reportingsjr/mppt/readme.md

Embedded Systems 4038C Final Project
Solar Panel Maximum Power Point Tracker
