reportingsjr/mppt/datasheets/IV_curve_solar_cell.png

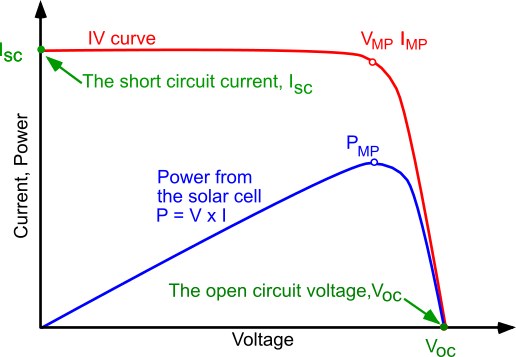
datasheets/IV_curve_solar_cell.png
