reportingsjr/mppt/hardware/mppt_power_controller.png

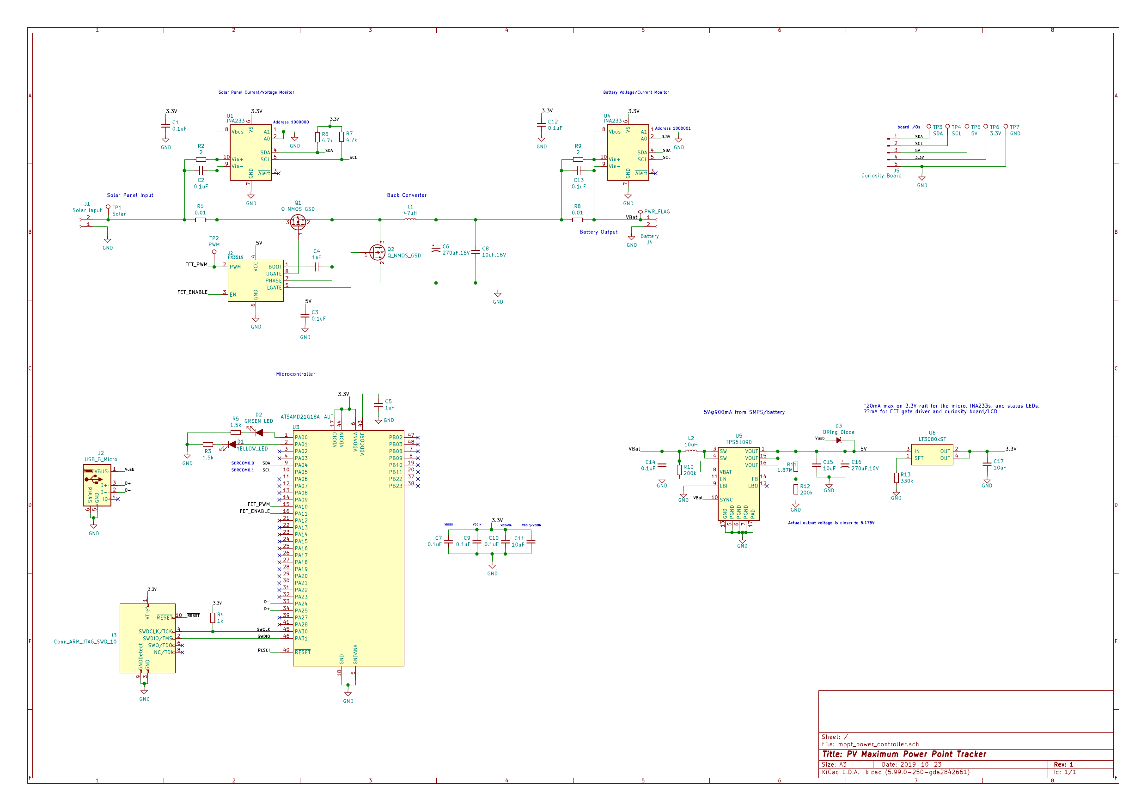
hardware/mppt_power_controller.png
