reportingsjr/mppt/hardware/mppt_power_controller.pdf

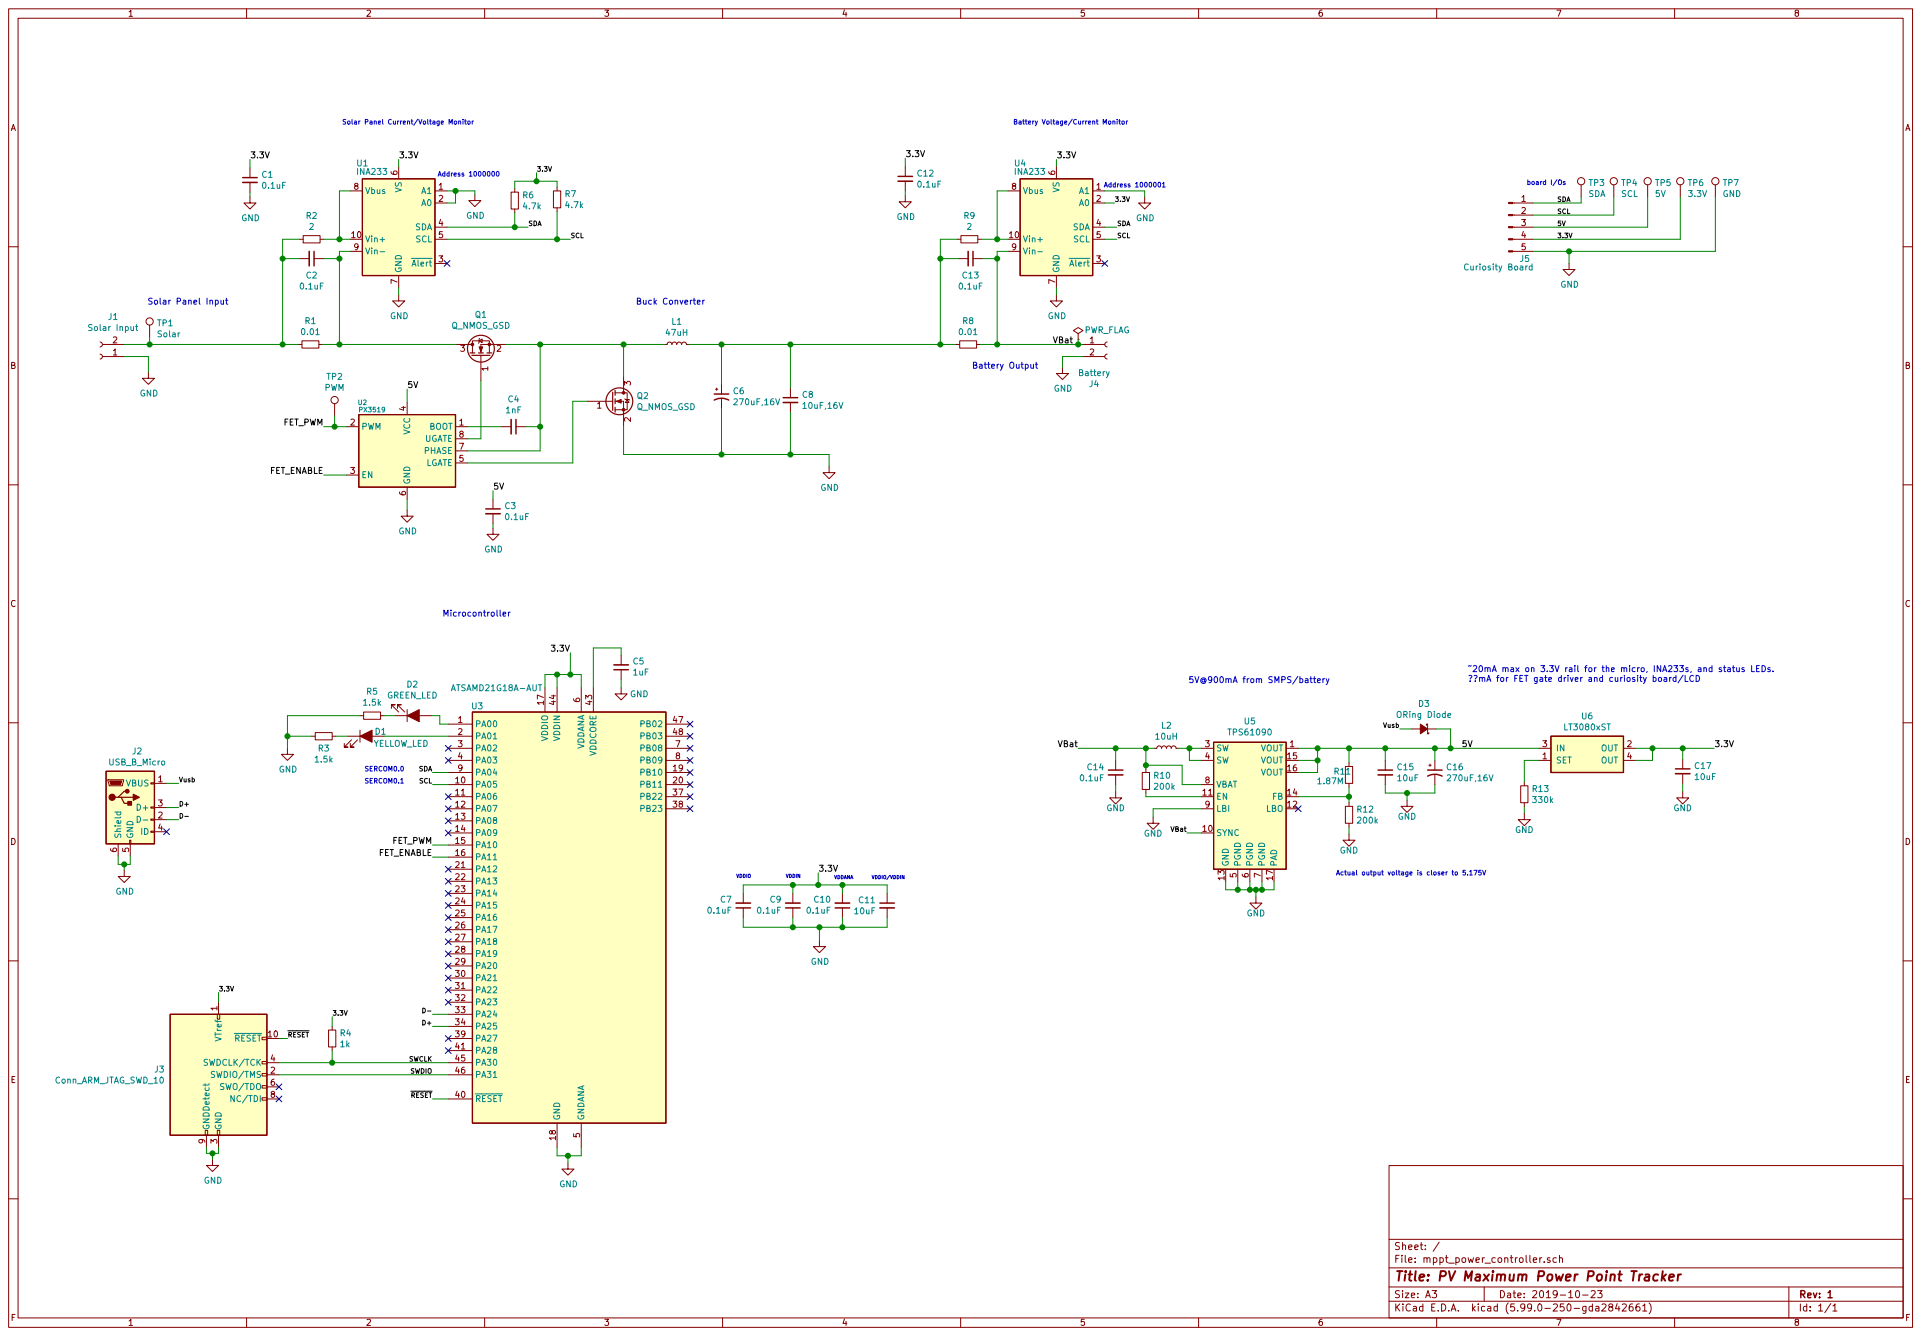
[picture p3: page 1]

5V@900mA from SMPS/battery Microcontroller 1

2 3 Q2 Q_NMOS_GSD VTref 1 RESET 10 SWDIO/TMS 2 GND

20mA max on 3.3V rail for the micro, INA233s, and status LEDs. ??mA for FET gate driver and curiosity board/LCD

3 SWDCLK/TCK 4 SWO/TDO 6 NC/TDI 8 GNDDetect 9

File: mppt_power_controller.sch Sheet: /
Id: 1/1 Title: PV Maximum Power Point Tracker
