reportingsjr/mppt/hardware/mppt_power_controller.kicad_pcb

## KiCad design hardware/mppt_power_controller.kicad_pcb (2020-04-10)

Schematic: mppt_power_controller.sch, PV Maximum Power Point Tracker

Parts:
C1, C2, C7, C9, C10, C12, C13, C19: 0.1uF; C_0603_1608Metric_Pad1.05x0.95mm_HandSolder
C3, C8: 10uF,16V; C_0805_2012Metric_Pad1.15x1.40mm_HandSolder
C4: 0.47uF; C_0603_1608Metric_Pad1.05x0.95mm_HandSolder
C5: 1uF; C_0603_1608Metric_Pad1.05x0.95mm_HandSolder
C11, C14, C15, C17: 10uF; C_0805_2012Metric_Pad1.15x1.40mm_HandSolder
C18: 270uF,16V; CP_Elec_8x6.9
D1: YELLOW_LED; LED_0603_1608Metric_Pad1.05x0.95mm_HandSolder
D2: GREEN_LED; LED_0603_1608Metric_Pad1.05x0.95mm_HandSolder
D3, D5: ORing Diode; D_SMB_Handsoldering
D4: D_SMB_Handsoldering
H1, H2, H3, H4: MountingHole; MountingHole_3.2mm_M3
J1: Solar Input; JST_PH_S2B-PH-K_1x02_P2.00mm_Horizontal
J2: USB_B_Micro; USB_Micro-B_Amphenol_10103594-0001LF_Horizontal
J3: Conn_ARM_JTAG_SWD_10; PinHeader_2x05_P1.27mm_Vertical_SMD
J4: Battery; JST_PH_S2B-PH-K_1x02_P2.00mm_Horizontal
J5: DISPLAY; JST_PH_S4B-PH-K_1x04_P2.00mm_Horizontal
L1: 10uH; L_Taiyo-Yuden_NR-80xx_HandSoldering
R1, R8: 0.01; R_0603_1608Metric_Pad1.05x0.95mm_HandSolder
R2, R9: 2; R_0603_1608Metric_Pad1.05x0.95mm_HandSolder
R3, R5: 1.5k; R_0603_1608Metric_Pad1.05x0.95mm_HandSolder
R4: 1k; R_0603_1608Metric_Pad1.05x0.95mm_HandSolder
R6, R7: 4.7k; R_0603_1608Metric_Pad1.05x0.95mm_HandSolder
R10, R11: 120k; R_0603_1608Metric_Pad1.05x0.95mm_HandSolder
R13: 330k; R_0603_1608Metric_Pad1.05x0.95mm_HandSolder
TP1: Solar; TestPoint_Keystone_5019_Minature
TP2, TP7: GND; TestPoint_Keystone_5019_Minature
TP3: SDA; TestPoint_Keystone_5019_Minature
TP4: SCL; TestPoint_Keystone_5019_Minature
TP5: Buck_EN; TestPoint_Keystone_5019_Minature
TP6: 3.3V; TestPoint_Keystone_5019_Minature
TP8: Battery; TestPoint_Keystone_5019_Minature
U1, U4: INA233; VSSOP-10_3x3mm_P0.5mm
U2: LT3971; MSOP-10-1EP_3x3mm_P0.5mm_EP1.68x1.88mm
U3: ATSAMD21G18A-AUT; TQFP-48_7x7mm_P0.5mm
U5: AD5141; QFN-16-1EP_3x3mm_P0.5mm_EP1.45x1.45mm
U6: LT3080xST; SOT-223

Connections:
/3.3V: C1.1, C7.2, C9.2, C10.2, C11.1, C12.1, C14.1, C17.1, C19.1, J3.1 (VTref), J5.3, R4.1, R6.1, R7.1, TP6.1, U1.6, U3.6 (VDDANA), U3.17 (VDDIO), U3.36 (VDDIO), U3.44 (VDDIN), U4.2, U4.6, U5.7 (~RESET~), U5.8 (DIS), U5.9 (VDD), U5.10 (VLOGIC), U5.13 (~WP~), U5.16 (~LRDAC~), U6.2 (OUT), U6.4 (OUT)
/Buck_EN: TP5.1, U2.5 (EN), U3.16 (PA11)
/D+: J2.3 (D+), U3.34 (PA25)
/D-: J2.2 (D-), U3.33 (PA24)
/SCL: J5.2, R7.2, TP4.1, U1.5, U3.14 (PA09), U4.5, U5.11 (CLK/SCL)
/SDA: J5.1, R6.2, TP3.1, U1.4, U3.13 (PA08), U4.4, U5.12 (SDI/SDA)
/SWCLK: J3.4 (SWDCLK/TCK), R4.2, U3.45 (PA30)
/SWDIO: J3.2 (SWDIO/TMS), U3.46 (PA31)
/VBat: C13.1, D5.2 (A), J4.1, R8.1, TP8.1, U4.9
/Vusb: D3.2 (A), J2.1 (VBUS)
/~RESET: J3.10 (~RESET~), U3.40 (~RESET)
GND: C1.2, C3.2, C5.1, C7.1, C8.2, C9.1, C10.1, C11.2, C12.2, C14.2, C15.2, C17.2, C18.2, C19.2, D1.1 (K), D2.1 (K), D4.2 (A), J1.2, J2.5 (GND), J2.6 (Shield), J3.3 (GND), J3.5 (GND), J3.9 (GNDDetect), J4.2, J5.4, R10.2, R13.2, TP2.1, TP7.1, U1.1, U1.2, U1.7, U2.10 (SYNC), U2.11 (GND), U3.5 (GNDANA), U3.18 (GND), U3.35 (GND), U3.42 (GND), U4.1, U4.7, U5.1 (GND), U5.3 (W), U5.4 (B), U5.5 (VSS), U5.6 (~SYNC~/ADDR0), U5.14 (SDO/ADDR1), U5.15 (INDEP), U5.17 (PAD)
unnamed: C2.2, J1.1, R1.2, R2.2, TP1.1
unnamed: C4.1, U2.2 (BOOST)
unnamed: C4.2, D4.1 (K), L1.1, U2.3 (SW)
unnamed: C5.2, U3.43 (VDDCORE)
unnamed: C8.1, C13.2, L1.2, R8.2, R9.2, R11.1, U2.1 (BD)
unnamed: C15.1, D3.1 (K), D5.1 (K), U6.3 (IN)
unnamed: C2.1, C3.1, C18.1, R1.1, U1.9, U2.4 (VIN)
unnamed: D1.2 (A), R3.1
unnamed: D2.2 (A), R5.1
unnamed: R2.1, U1.8, U1.10
unnamed: R3.2, U3.2 (PA01)
unnamed: R5.2, U3.1 (PA00)
unnamed: R9.1, U4.8, U4.10
unnamed: R10.1, U2.8 (RT)
unnamed: R11.2, U2.6 (FB), U5.2 (A)
unnamed: R13.1, U6.1 (SET)

Notes on the sheet:
Solar Panel Input
~~20mA max on 3.3V rail for the micro, INA233s, and status LEDs.
board I/Os
Solar Panel Current/Voltage Monitor
Address 0b1000000 (0x40)
approx 400kHz switching freq
Battery Voltage/Current Monitor
Battery Output
Address 0b0101111 (0x2F)
Address 0b1000001 (0x41)
SERCOM2.0
SERCOM2.1
Microcontroller
VDDIO
VDDIN
VDDANA
VDDIO/VDDIN

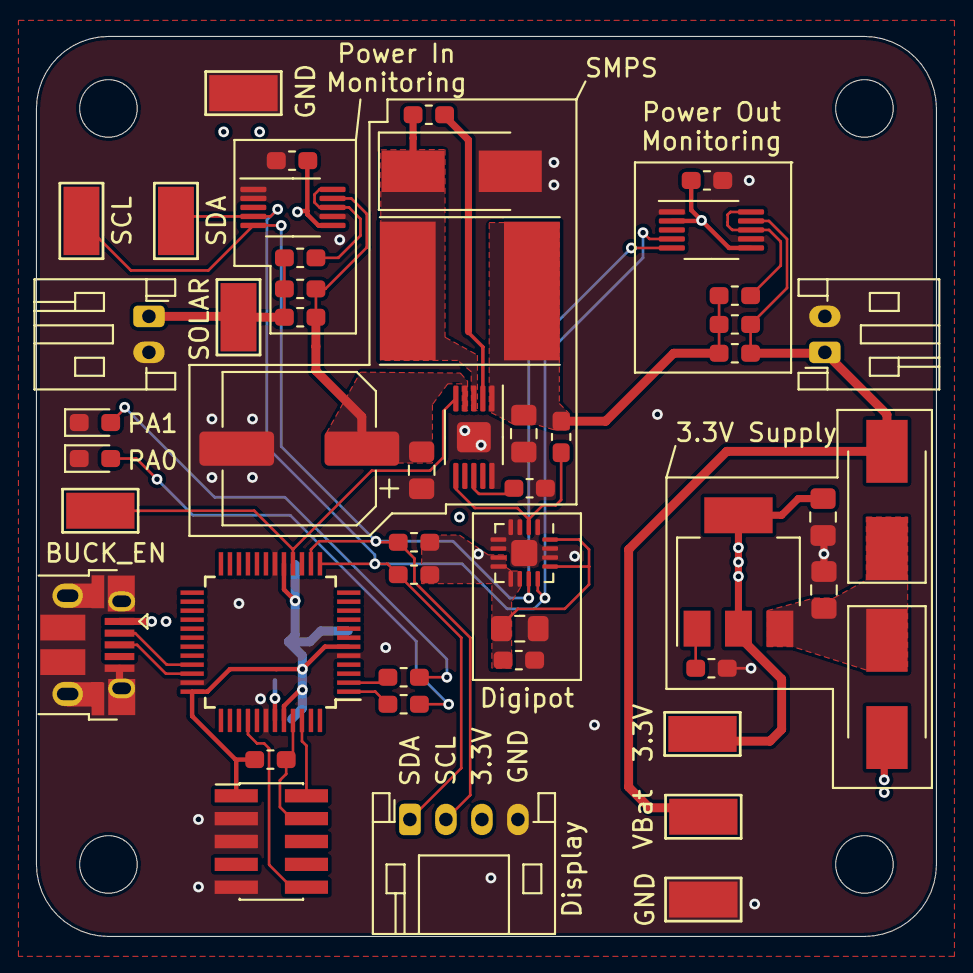
[picture p4: board mppt_power_controller.kicad_pcb from above]

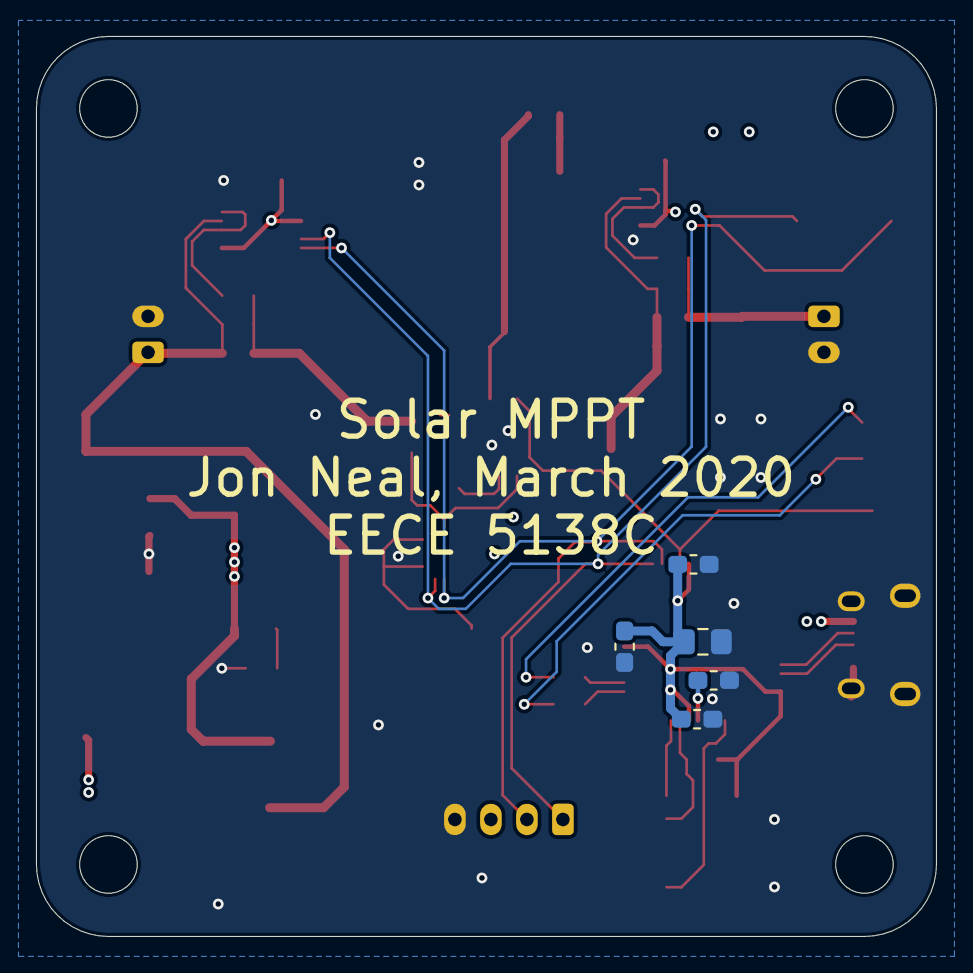
[picture p5: board mppt_power_controller.kicad_pcb from below]

Board: 4 copper layers, 50.0 x 50.0 mm, 58 parts (5 on the bottom side), 28 nets.
