reportingsjr/mppt/power_firmware/MyProject/atmel_start_pins.h

/*
 * Code generated from Atmel Start.
 *
 * This file will be overwritten when reconfiguring your Atmel Start project.
 * Please copy examples or other code you want to keep to a separate file
 * to avoid losing it when reconfiguring.
 */
#ifndef ATMEL_START_PINS_H_INCLUDED
#define ATMEL_START_PINS_H_INCLUDED

#include <hal_gpio.h>

// SAMD21 has 8 pin functions

#define GPIO_PIN_FUNCTION_A 0
#define GPIO_PIN_FUNCTION_B 1
#define GPIO_PIN_FUNCTION_C 2
#define GPIO_PIN_FUNCTION_D 3
#define GPIO_PIN_FUNCTION_E 4
#define GPIO_PIN_FUNCTION_F 5
#define GPIO_PIN_FUNCTION_G 6
#define GPIO_PIN_FUNCTION_H 7

#define yellow_led GPIO(GPIO_PORTA, 0)
#define green_led GPIO(GPIO_PORTA, 1)
#define I2C_SDA GPIO(GPIO_PORTA, 8)
#define I2C_SCL GPIO(GPIO_PORTA, 9)
#define fet_pwm GPIO(GPIO_PORTA, 10)
#define fet_enable GPIO(GPIO_PORTA, 11)

#endif // ATMEL_START_PINS_H_INCLUDED
