reportingsjr/mppt/power_firmware/MyProject/driver_init.c

/*
 * Code generated from Atmel Start.
 *
 * This file will be overwritten when reconfiguring your Atmel Start project.
 * Please copy examples or other code you want to keep to a separate file
 * to avoid losing it when reconfiguring.
 */

#include "driver_init.h"
#include <peripheral_clk_config.h>
#include <utils.h>
#include <hal_init.h>
#include <hpl_gclk_base.h>
#include <hpl_pm_base.h>

struct i2c_m_sync_desc I2C_0;

struct pwm_descriptor PWM_0;

void I2C_0_PORT_init(void)
{

	gpio_set_pin_pull_mode(I2C_SDA,
	                       // <y> Pull configuration
	                       // <id> pad_pull_config
	                       // <GPIO_PULL_OFF"> Off
	                       // <GPIO_PULL_UP"> Pull-up
	                       // <GPIO_PULL_DOWN"> Pull-down
	                       GPIO_PULL_OFF);

	gpio_set_pin_function(I2C_SDA, PINMUX_PA08C_SERCOM0_PAD0);

	gpio_set_pin_pull_mode(I2C_SCL,
	                       // <y> Pull configuration
	                       // <id> pad_pull_config
	                       // <GPIO_PULL_OFF"> Off
	                       // <GPIO_PULL_UP"> Pull-up
	                       // <GPIO_PULL_DOWN"> Pull-down
	                       GPIO_PULL_OFF);

	gpio_set_pin_function(I2C_SCL, PINMUX_PA09C_SERCOM0_PAD1);
}

void I2C_0_CLOCK_init(void)
{
	_pm_enable_bus_clock(PM_BUS_APBC, SERCOM0);
	_gclk_enable_channel(SERCOM0_GCLK_ID_CORE, CONF_GCLK_SERCOM0_CORE_SRC);
	_gclk_enable_channel(SERCOM0_GCLK_ID_SLOW, CONF_GCLK_SERCOM0_SLOW_SRC);
}

void I2C_0_init(void)
{
	I2C_0_CLOCK_init();
	i2c_m_sync_init(&I2C_0, SERCOM0);
	I2C_0_PORT_init();
}

void PWM_0_PORT_init(void)
{

	gpio_set_pin_function(fet_pwm, PINMUX_PA10E_TCC1_WO0);
}

void PWM_0_CLOCK_init(void)
{
	_pm_enable_bus_clock(PM_BUS_APBC, TCC1);
	_gclk_enable_channel(TCC1_GCLK_ID, CONF_GCLK_TCC1_SRC);
}

void PWM_0_init(void)
{
	PWM_0_CLOCK_init();
	PWM_0_PORT_init();
	pwm_init(&PWM_0, TCC1, _tcc_get_pwm());
}

void system_init(void)
{
	init_mcu();

	// GPIO on PA00

	gpio_set_pin_level(yellow_led,
	                   // <y> Initial level
	                   // <id> pad_initial_level
	                   // <false"> Low
	                   // <true"> High
	                   false);

	// Set pin direction to output
	gpio_set_pin_direction(yellow_led, GPIO_DIRECTION_OUT);

	gpio_set_pin_function(yellow_led, GPIO_PIN_FUNCTION_OFF);

	// GPIO on PA01

	gpio_set_pin_level(green_led,
	                   // <y> Initial level
	                   // <id> pad_initial_level
	                   // <false"> Low
	                   // <true"> High
	                   false);

	// Set pin direction to output
	gpio_set_pin_direction(green_led, GPIO_DIRECTION_OUT);

	gpio_set_pin_function(green_led, GPIO_PIN_FUNCTION_OFF);

	// GPIO on PA11

	gpio_set_pin_level(fet_enable,
	                   // <y> Initial level
	                   // <id> pad_initial_level
	                   // <false"> Low
	                   // <true"> High
	                   false);

	// Set pin direction to output
	gpio_set_pin_direction(fet_enable, GPIO_DIRECTION_OUT);

	gpio_set_pin_function(fet_enable, GPIO_PIN_FUNCTION_OFF);

	I2C_0_init();

	PWM_0_init();
}
