reportingsjr/mppt/power_firmware/MyProject/oled_fonts.h

/*
 * oled_fonts.h
 *
 * Created: 8/6/2016 8:49:02 PM
 *  Author: Philip
 */ 


#ifndef OLED_FONTS_H_
#define OLED_FONTS_H_

#include <atmel_start.h>

typedef struct {
	
	const unsigned char* font; // your font array
	const unsigned int (*descriptors)[3]; // your font info
	const unsigned char* charmap; // your char map
	int num_of_chars; // number of characters in your font set	
	int height;
	int width;
	int offSet;
	uint8_t last_font_width;
	uint8_t space;
} oled_font_info;

oled_font_info font;

// Character bitmaps for Arial 6pt
const unsigned char arial_6ptBitmaps[] =
{
	// @0 ' ' (8 pixels wide)
	0x00, //
	0x00, //
	0x00, //
	0x00, //
	0x00, //
	0x00, //
	0x00, //
	0x00, //

	// @8 '!' (8 pixels wide)
	0x10, //     #
	0x10, //     #
	0x10, //     #
	0x10, //     #
	0x00, //
	0x10, //     #
	0x00, //
	0x00, //

	// @16 '"' (8 pixels wide)
	0x18, //    ##
	0x18, //    ##
	0x00, //
	0x00, //
	0x00, //
	0x00, //
	0x00, //
	0x00, //

	// @24 '#' (8 pixels wide)
	0x50, //     # #
	0x78, //    ####
	0x50, //     # #
	0x78, //    ####
	0x28, //    # #
	0x28, //    # #
	0x00, //
	0x00, //

	// @32 '$' (8 pixels wide)
	0xF0, //     ####
	0x28, //    # #
	0x30, //     ##
	0xE0, //      ###
	0xA8, //    # # #
	0x70, //     ###
	0x20, //      #
	0x00, //

	// @40 '%' (8 pixels wide)
	0x24, //   #  #
	0x1A, //  # ##
	0x14, //   # #
	0x30, //     ##
	0x58, //    ## #
	0x28, //    # #
	0x00, //
	0x00, //

	// @48 '&' (8 pixels wide)
	0x38, //    ###
	0x28, //    # #
	0x10, //     #
	0x5C, //   ### #
	0x24, //   #  #
	0x78, //    ####
	0x00, //
	0x00, //

	// @56 ''' (8 pixels wide)
	0x10, //     #
	0x10, //     #
	0x00, //
	0x00, //
	0x00, //
	0x00, //
	0x00, //
	0x00, //

	// @64 '(' (8 pixels wide)
	0x40, //       #
	0x20, //      #
	0x10, //     #
	0x10, //     #
	0x10, //     #
	0x10, //     #
	0x20, //      #
	0x40, //       #

	// @72 ')' (8 pixels wide)
	0x04, //   #
	0x08, //    #
	0x10, //     #
	0x10, //     #
	0x10, //     #
	0x10, //     #
	0x08, //    #
	0x04, //   #

	// @80 '*' (8 pixels wide)
	0x10, //     #
	0x18, //    ##
	0x00, //
	0x00, //
	0x00, //
	0x00, //
	0x00, //
	0x00, //

	// @88 '+' (8 pixels wide)
	0x00, //
	0x10, //     #
	0x10, //     #
	0x7C, //   #####
	0x10, //     #
	0x10, //     #
	0x00, //
	0x00, //

	// @96 ',' (8 pixels wide)
	0x00, //
	0x00, //
	0x00, //
	0x00, //
	0x00, //
	0x10, //     #
	0x10, //     #
	0x00, //

	// @104 '-' (8 pixels wide)
	0x00, //
	0x00, //
	0x00, //
	0x38, //    ###
	0x00, //
	0x00, //
	0x00, //
	0x00, //

	// @112 '.' (8 pixels wide)
	0x00, //
	0x00, //
	0x00, //
	0x00, //
	0x00, //
	0x10, //     #
	0x00, //
	0x00, //

	// @120 '/' (8 pixels wide)
	0x20, //      #
	0x10, //     #
	0x10, //     #
	0x10, //     #
	0x08, //    #
	0x08, //    #
	0x00, //
	0x00, //

	// @128 '0' (8 pixels wide)
	0x78, //    ####
	0x48, //    #  #
	0x48, //    #  #
	0x48, //    #  #
	0x48, //    #  #
	0x78, //    ####
	0x00, //
	0x00, //

	// @136 '1' (8 pixels wide)
	0x20, //      #
	0x30, //     ##
	0x20, //      #
	0x20, //      #
	0x20, //      #
	0x20, //      #
	0x00, //
	0x00, //

	// @144 '2' (8 pixels wide)
	0x70, //     ###
	0x48, //    #  #
	0x40, //       #
	0x20, //      #
	0x10, //     #
	0x78, //    ####
	0x00, //
	0x00, //

	// @152 '3' (8 pixels wide)
	0x78, //    ####
	0x40, //       #
	0x60, //      ##
	0x40, //       #
	0x48, //    #  #
	0x30, //     ##
	0x00, //
	0x00, //

	// @160 '4' (8 pixels wide)
	0x20, //      #
	0x20, //      #
	0x30, //     ##
	0x30, //     ##
	0x70, //     ###
	0x20, //      #
	0x00, //
	0x00, //

	// @168 '5' (8 pixels wide)
	0x70, //     ###
	0x08, //    #
	0x38, //    ###
	0x40, //       #
	0x48, //    #  #
	0x30, //     ##
	0x00, //
	0x00, //

	// @176 '6' (8 pixels wide)
	0x70, //     ###
	0x08, //    #
	0x38, //    ###
	0x48, //    #  #
	0x48, //    #  #
	0x30, //     ##
	0x00, //
	0x00, //

	// @184 '7' (8 pixels wide)
	0x38, //    ###
	0x20, //      #
	0x10, //     #
	0x10, //     #
	0x10, //     #
	0x10, //     #
	0x00, //
	0x00, //

	// @192 '8' (8 pixels wide)
	0x78, //    ####
	0x48, //    #  #
	0x30, //     ##
	0x48, //    #  #
	0x48, //    #  #
	0x30, //     ##
	0x00, //
	0x00, //

	// @200 '9' (8 pixels wide)
	0x30, //     ##
	0x48, //    #  #
	0x48, //    #  #
	0x70, //     ###
	0x40, //       #
	0x38, //    ###
	0x00, //
	0x00, //

	// @208 ':' (8 pixels wide)
	0x00, //
	0x10, //     #
	0x00, //
	0x00, //
	0x00, //
	0x10, //     #
	0x00, //
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
	0x10, //     #
	0x10, //     #
	0x10, //     #
	0x10, //     #
	0x10, //     #
	0x10, //     #
	0x10, //     #
	0x00, //

	// @600 'k' (8 pixels wide)
	0x08, //    #
	0x28, //    # #
	0x18, //    ##
	0x18, //    ##
	0x28, //    # #
	0x28, //    # #
	0x00, //
	0x00, //

	// @608 'l' (8 pixels wide)
	0x20, //      #
	0x20, //      #
	0x20, //      #
	0x20, //      #
	0x20, //      #
	0x20, //      #
	0x00, //
	0x00, //

	// @616 'm' (8 pixels wide)
	0x00, //
	0x3C, //   ####
	0x54, //   # # #
	0x54, //   # # #
	0x54, //   # # #
	0x54, //   # # #
	0x00, //
	0x00, //

	// @624 'n' (8 pixels wide)
	0x00, //
	0x10, //     #
	0x30, //     ##
	0x30, //     ##
	0x30, //     ##
	0x30, //     ##
	0x00, //
	0x00, //

	// @632 'o' (8 pixels wide)
	0x00, //
	0x30, //     ##
	0x48, //    #  #
	0x48, //    #  #
	0x48, //    #  #
	0x30, //     ##
	0x00, //
	0x00, //

	// @640 'p' (8 pixels wide)
	0x00, //
	0x38, //    ###
	0x48, //    #  #
	0x48, //    #  #
	0x48, //    #  #
	0x38, //    ###
	0x08, //    #
	0x08, //    #

	// @648 'q' (8 pixels wide)
	0x00, //
	0x38, //    ###
	0x24, //   #  #
	0x24, //   #  #
	0x24, //   #  #
	0x38, //    ###
	0x20, //      #
	0x20, //      #

	// @656 'r' (8 pixels wide)
	0x00, //
	0x30, //     ##
	0x10, //     #
	0x10, //     #
	0x10, //     #
	0x10, //     #
	0x00, //
	0x00, //

	// @664 's' (8 pixels wide)
	0x00, //
	0x18, //    ##
	0x0C, //   ##
	0x08, //    #
	0x14, //   # #
	0x0C, //   ##
	0x00, //
	0x00, //

	// @672 't' (8 pixels wide)
	0x10, //     #
	0x38, //    ###
	0x10, //     #
	0x10, //     #
	0x10, //     #
	0x30, //     ##
	0x00, //
	0x00, //

	// @680 'u' (8 pixels wide)
	0x00, //
	0x30, //     ##
	0x30, //     ##
	0x30, //     ##
	0x30, //     ##
	0x20, //      #
	0x00, //
	0x00, //

	// @688 'v' (8 pixels wide)
	0x00, //
	0x28, //    # #
	0x28, //    # #
	0x28, //    # #
	0x28, //    # #
	0x38, //    ###
	0x00, //
	0x00, //

	// @696 'w' (8 pixels wide)
	0x00, //
	0x54, //   # # #
	0x5C, //   ### #
	0x5C, //   ### #
	0x5C, //   ### #
	0x28, //    # #
	0x00, //
	0x00, //

	// @704 'x' (8 pixels wide)
	0x00, //
	0x28, //    # #
	0x10, //     #
	0x10, //     #
	0x10, //     #
	0x28, //    # #
	0x00, //
	0x00, //

	// @712 'y' (8 pixels wide)
	0x00, //
	0x44, //   #   #
	0x28, //    # #
	0x28, //    # #
	0x28, //    # #
	0x10, //     #
	0x10, //     #
	0x10, //     #

	// @720 'z' (8 pixels wide)
	0x00, //
	0x3C, //   ####
	0x10, //     #
	0x08, //    #
	0x08, //    #
	0x3C, //   ####
	0x00, //
	0x00, //

	// @728 '{' (8 pixels wide)
	0x30, //     ##
	0x10, //     #
	0x10, //     #
	0x08, //    #
	0x10, //     #
	0x10, //     #
	0x10, //     #
	0x30, //     ##

	// @736 '|' (8 pixels wide)
	0x10, //     #
	0x10, //     #
	0x10, //     #
	0x10, //     #
	0x10, //     #
	0x10, //     #
	0x10, //     #
	0x10, //     #

	// @744 '}' (8 pixels wide)
	0x18, //    ##
	0x10, //     #
	0x10, //     #
	0x20, //      #
	0x10, //     #
	0x10, //     #
	0x10, //     #
	0x18, //    ##

	// @752 '~' (8 pixels wide)
	0x00, //
	0x00, //
	0x00, //
	0x0C, //   ##
	0x30, //     ##
	0x00, //
	0x00, //
	0x00, //
};

// Character descriptors for Arial 6pt
// { [Char width in bits], [Char height in bits], [Offset into arial_6ptCharBitmaps in bytes] }
const unsigned int arial_6ptDescriptors[96][3] =
{
	{8, 8, 0}, 		//
	{8, 8, 8}, 		// !
	{8, 8, 16}, 		// "
	{8, 8, 24}, 		// #
	{8, 8, 32}, 		// $
	{8, 8, 40}, 		// %
	{8, 8, 48}, 		// &
	{8, 8, 56}, 		// '
	{8, 8, 64}, 		// (
	{8, 8, 72}, 		// )
	{8, 8, 80}, 		// *
	{8, 8, 88}, 		// +
	{8, 8, 96}, 		// ,
	{8, 8, 104}, 		// -
	{8, 8, 112}, 		// .
	{8, 8, 120}, 		// /
	{8, 8, 128}, 		// 0
	{8, 8, 136}, 		// 1
	{8, 8, 144}, 		// 2
	{8, 8, 152}, 		// 3
	{8, 8, 160}, 		// 4
	{8, 8, 168}, 		// 5
	{8, 8, 176}, 		// 6
	{8, 8, 184}, 		// 7
	{8, 8, 192}, 		// 8
	{8, 8, 200}, 		// 9
	{8, 8, 208}, 		// :
	{8, 8, 216}, 		// ;
	{8, 8, 224}, 		// <
	{8, 8, 232}, 		// =
	{8, 8, 240}, 		// >
	{8, 8, 248}, 		// ?
	{8, 8, 256}, 		// @
	{8, 8, 264}, 		// A
	{8, 8, 272}, 		// B
	{8, 8, 280}, 		// C
	{8, 8, 288}, 		// D
	{8, 8, 296}, 		// E
	{8, 8, 304}, 		// F
	{8, 8, 312}, 		// G
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
	{8, 8, 480}, 		// forward slash
	{8, 8, 488}, 		// ]
	{8, 8, 496}, 		// ^
	{8, 8, 504}, 		// _
	{8, 8, 512}, 		// `
	{8, 8, 520}, 		// a
	{8, 8, 528}, 		// b
	{8, 8, 536}, 		// c
	{8, 8, 544}, 		// d
	{8, 8, 552}, 		// e
	{8, 8, 560}, 		// f
	{8, 8, 568}, 		// g
	{8, 8, 576}, 		// h
	{8, 8, 584}, 		// i
	{8, 8, 592}, 		// j
	{8, 8, 600}, 		// k
	{8, 8, 608}, 		// l
	{8, 8, 616}, 		// m
	{8, 8, 624}, 		// n
	{8, 8, 632}, 		// o
	{8, 8, 640}, 		// p
	{8, 8, 648}, 		// q
	{8, 8, 656}, 		// r
	{8, 8, 664}, 		// s
	{8, 8, 672}, 		// t
	{8, 8, 680}, 		// u
	{8, 8, 688}, 		// v
	{8, 8, 696}, 		// w
	{8, 8, 704}, 		// x
	{8, 8, 712}, 		// y
	{8, 8, 720}, 		// z
	{8, 8, 728}, 		// {
	{8, 8, 736}, 		// |
	{8, 8, 744}, 		// }
	{8, 8, 752}, 		// ~
};


const unsigned char charMap[96] =
{
	0x20,   // space
	0x21,   // !
	0x22,   // "
	0x23,   // #
	0x24,   // $
	0x25,   // %
	0x26,   // &
	0x27,   // '
	0x28,   // (
	0x29,   // )
	0x2A,   // *
	0x2B,   // +
	0x2C,   // ,
	0x2D,   // -
	0x2E,   // .
	0x2F,   // /
	0x30,   // 0
	0x31,   // 1
	0x32,   // 2
	0x33,   // 3
	0x34,   // 4
	0x35,   // 5
	0x36,   // 6
	0x37,   // 7
	0x38,   // 8
	0x39,   // 9
	0x3A,   // :
	0x3B,   // ;
	0x3C,   // <
	0x3D,   // =
	0x3E,   // >
	0x3F,   // @
	0x40,   // ?
	0x41,   // A
	0x42,   // B
	0x43,   // C
	0x44,   // D
	0x45,   // E
	0x46,   // F
	0x47,   // G
	0x48,   // H
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
	0x5C,   // slash
	0x5D,   // ]
	0x5E,   // ^
	0x5F,   // _
	0x60,   // `
	0x61,   // a
	0x62,   // b
	0x63,   // c
	0x64,   // d
	0x65,   // e
	0x66,   // f
	0x67,   // g
	0x68,   // h
	0x69,   // i
	0x6A,   // j
	0x6B,   // k
	0x6C,   // l
	0x6D,   // m
	0x6E,   // n
	0x6F,   // o
	0x70,   // p
	0x71,   // q
	0x72,   // r
	0x73,   // s
	0x74,   // t
	0x75,   // u
	0x76,   // v
	0x77,   // w
	0x78,   // x
	0x79,   // y
	0x7A,   // z
	0x7B,   // {
	0x7C,   // |
	0x7D,   // }
	0x7E   // ~

};

//
//  Font data for Arial 8pt
//

// Character bitmaps for Arial 8pt
const unsigned char arial_8ptBitmaps[] =
{
	// @0 ' ' (2 pixels wide)
	0x00, //
	0x00, //
	0x00, //
	0x00, //
	0x00, //
	0x00, //
	0x00, //
	0x00, //
	0x00, //
	0x00, //
	0x00, //
	0x00, //
	0x00, //
	0x00, //

	// @14 '!' (2 pixels wide)
	0x03, // ##
	0x03, // ##
	0x03, // ##
	0x03, // ##
	0x03, // ##
	0x00, //
	0x03, // ##
	0x03, // ##

	// @22 '"' (5 pixels wide)
	0x1B, // ## ##
	0x1B, // ## ##
	0x1B, // ## ##

	// @25 '#' (6 pixels wide)
	0x24, //   #  #
	0x24, //   #  #
	0x3F, // ######
	0x12, //  #  #
	0x12, //  #  #
	0x3F, // ######
	0x09, // #  #
	0x09, // #  #

	// @33 '$' (5 pixels wide)
	0x04, //   #
	0x0E, //  ###
	0x15, // # # #
	0x05, // # #
	0x0F, // ####
	0x1E, //  ####
	0x14, //   # #
	0x15, // # # #
	0x0E, //  ###
	0x04, //   #

	// @43 '%' (8 pixels wide)
	0x27, // ###  #
	0x25, // # #  #
	0x15, // # # #
	0x17, // ### #
	0xE8, //    # ###
	0xA8, //    # # #
	0xA4, //   #  # #
	0xE4, //   #  ###

	// @51 '&' (7 pixels wide)
	0x1C, //   ###
	0x36, //  ## ##
	0x36, //  ## ##
	0x0C, //   ##
	0x5E, //  #### #
	0x73, // ##  ###
	0x33, // ##  ##
	0x7E, //  ######

	// @59 ''' (2 pixels wide)
	0x03, // ##
	0x03, // ##
	0x03, // ##

	// @62 '(' (3 pixels wide)
	0x04, //   #
	0x06, //  ##
	0x03, // ##
	0x03, // ##
	0x03, // ##
	0x03, // ##
	0x03, // ##
	0x02, //  #
	0x06, //  ##
	0x04, //   #

	// @72 ')' (3 pixels wide)
	0x01, // #
	0x02, //  #
	0x02, //  #
	0x06, //  ##
	0x06, //  ##
	0x06, //  ##
	0x06, //  ##
	0x02, //  #
	0x03, // ##
	0x01, // #

	// @82 '*' (3 pixels wide)
	0x02, //  #
	0x07, // ###
	0x02, //  #
	0x05, // # #

	// @86 '+' (5 pixels wide)
	0x04, //   #
	0x04, //   #
	0x1F, // #####
	0x04, //   #
	0x04, //   #

	// @91 ',' (2 pixels wide)
	0x03, // ##
	0x03, // ##
	0x02, //  #
	0x01, // #

	// @95 '-' (3 pixels wide)
	0x07, // ###

	// @96 '.' (2 pixels wide)
	0x03, // ##
	0x03, // ##

	// @98 '/' (3 pixels wide)
	0x04, //   #
	0x04, //   #
	0x02, //  #
	0x02, //  #
	0x02, //  #
	0x02, //  #
	0x01, // #
	0x01, // #

	// @106 '0' (5 pixels wide)
	0x0E, //  ###
	0x1B, // ## ##
	0x1B, // ## ##
	0x1B, // ## ##
	0x1B, // ## ##
	0x1B, // ## ##
	0x1B, // ## ##
	0x0E, //  ###

	// @114 '1' (4 pixels wide)
	0x0C, //   ##
	0x0E, //  ###
	0x0F, // ####
	0x0D, // # ##
	0x0C, //   ##
	0x0C, //   ##
	0x0C, //   ##
	0x0C, //   ##

	// @122 '2' (5 pixels wide)
	0x0E, //  ###
	0x1B, // ## ##
	0x18, //    ##
	0x18, //    ##
	0x0C, //   ##
	0x06, //  ##
	0x03, // ##
	0x1F, // #####

	// @130 '3' (5 pixels wide)
	0x0E, //  ###
	0x1B, // ## ##
	0x18, //    ##
	0x0C, //   ##
	0x18, //    ##
	0x18, //    ##
	0x1B, // ## ##
	0x0E, //  ###

	// @138 '4' (6 pixels wide)
	0x18, //    ##
	0x1C, //   ###
	0x1A, //  # ##
	0x1A, //  # ##
	0x19, // #  ##
	0x3F, // ######
	0x18, //    ##
	0x18, //    ##

	// @146 '5' (5 pixels wide)
	0x1E, //  ####
	0x06, //  ##
	0x03, // ##
	0x0F, // ####
	0x19, // #  ##
	0x18, //    ##
	0x1B, // ## ##
	0x0E, //  ###

	// @154 '6' (5 pixels wide)
	0x0E, //  ###
	0x1B, // ## ##
	0x03, // ##
	0x0F, // ####
	0x1B, // ## ##
	0x1B, // ## ##
	0x1B, // ## ##
	0x0E, //  ###

	// @162 '7' (5 pixels wide)
	0x1F, // #####
	0x18, //    ##
	0x0C, //   ##
	0x0C, //   ##
	0x06, //  ##
	0x06, //  ##
	0x06, //  ##
	0x06, //  ##

	// @170 '8' (5 pixels wide)
	0x0E, //  ###
	0x1B, // ## ##
	0x1B, // ## ##
	0x0E, //  ###
	0x1B, // ## ##
	0x1B, // ## ##
	0x1B, // ## ##
	0x0E, //  ###

	// @178 '9' (5 pixels wide)
	0x0E, //  ###
	0x1B, // ## ##
	0x1B, // ## ##
	0x1B, // ## ##
	0x1E, //  ####
	0x18, //    ##
	0x1B, // ## ##
	0x0E, //  ###

	// @186 ':' (2 pixels wide)
	0x03, // ##
	0x03, // ##
	0x00, //
	0x00, //
	0x03, // ##
	0x03, // ##

	// @192 ';' (2 pixels wide)
	0x03, // ##
	0x03, // ##
	0x00, //
	0x00, //
	0x03, // ##
	0x03, // ##
	0x02, //  #
	0x01, // #

	// @200 '<' (5 pixels wide)
	0x10, //     #
	0x0C, //   ##
	0x03, // ##
	0x03, // ##
	0x0C, //   ##
	0x10, //     #

	// @206 '=' (5 pixels wide)
	0x1F, // #####
	0x00, //
	0x1F, // #####

	// @209 '>' (5 pixels wide)
	0x01, // #
	0x06, //  ##
	0x18, //    ##
	0x18, //    ##
	0x06, //  ##
	0x01, // #

	// @215 '?' (5 pixels wide)
	0x0E, //  ###
	0x1B, // ## ##
	0x18, //    ##
	0x0C, //   ##
	0x06, //  ##
	0x00, //
	0x06, //  ##
	0x06, //  ##

	// @223 '@' (10 pixels wide)
	0xF8, 0x00, //    #####
	0x06, 0x01, //  ##     #
	0xFA, 0x02, //  # ##### #
	0xC9, 0x02, // #  #  ## #
	0x45, 0x02, // # #   #  #
	0x45, 0x02, // # #   #  #
	0x65, 0x01, // # #  ## #
	0xFA, 0x00, //  # #####
	0x06, 0x03, //  ##     ##
	0xF8, 0x00, //    #####

	// @243 'A' (7 pixels wide)
	0x1C, //   ###
	0x1C, //   ###
	0x36, //  ## ##
	0x36, //  ## ##
	0x36, //  ## ##
	0x7F, // #######
	0x63, // ##   ##
	0x63, // ##   ##

	// @251 'B' (6 pixels wide)
	0x1F, // #####
	0x33, // ##  ##
	0x33, // ##  ##
	0x1F, // #####
	0x33, // ##  ##
	0x33, // ##  ##
	0x33, // ##  ##
	0x1F, // #####

	// @259 'C' (7 pixels wide)
	0x3C, //   ####
	0x66, //  ##  ##
	0x03, // ##
	0x03, // ##
	0x03, // ##
	0x03, // ##
	0x66, //  ##  ##
	0x3C, //   ####

	// @267 'D' (6 pixels wide)
	0x1F, // #####
	0x33, // ##  ##
	0x33, // ##  ##
	0x33, // ##  ##
	0x33, // ##  ##
	0x33, // ##  ##
	0x33, // ##  ##
	0x1F, // #####

	// @275 'E' (5 pixels wide)
	0x1F, // #####
	0x03, // ##
	0x03, // ##
	0x1F, // #####
	0x03, // ##
	0x03, // ##
	0x03, // ##
	0x1F, // #####

	// @283 'F' (5 pixels wide)
	0x1F, // #####
	0x03, // ##
	0x03, // ##
	0x1F, // #####
	0x03, // ##
	0x03, // ##
	0x03, // ##
	0x03, // ##

	// @291 'G' (7 pixels wide)
	0x3C, //   ####
	0x66, //  ##  ##
	0x03, // ##
	0x03, // ##
	0x73, // ##  ###
	0x63, // ##   ##
	0x66, //  ##  ##
	0x3C, //   ####

	// @299 'H' (6 pixels wide)
	0x33, // ##  ##
	0x33, // ##  ##
	0x33, // ##  ##
	0x3F, // ######
	0x33, // ##  ##
	0x33, // ##  ##
	0x33, // ##  ##
	0x33, // ##  ##

	// @307 'I' (2 pixels wide)
	0x03, // ##
	0x03, // ##
	0x03, // ##
	0x03, // ##
	0x03, // ##
	0x03, // ##
	0x03, // ##
	0x03, // ##

	// @315 'J' (5 pixels wide)
	0x18, //    ##
	0x18, //    ##
	0x18, //    ##
	0x18, //    ##
	0x18, //    ##
	0x18, //    ##
	0x1B, // ## ##
	0x0E, //  ###

	// @323 'K' (6 pixels wide)
	0x33, // ##  ##
	0x1B, // ## ##
	0x1B, // ## ##
	0x0F, // ####
	0x1F, // #####
	0x1B, // ## ##
	0x33, // ##  ##
	0x33, // ##  ##

	// @331 'L' (6 pixels wide)
	0x03, // ##
	0x03, // ##
	0x03, // ##
	0x03, // ##
	0x03, // ##
	0x03, // ##
	0x03, // ##
	0x3F, // ######

	// @339 'M' (9 pixels wide)
	0xC7, 0x01, // ###   ###
	0xC7, 0x01, // ###   ###
	0xEF, 0x01, // #### ####
	0xEF, 0x01, // #### ####
	0xAB, 0x01, // ## # # ##
	0xBB, 0x01, // ## ### ##
	0xBB, 0x01, // ## ### ##
	0x93, 0x01, // ##  #  ##

	// @355 'N' (6 pixels wide)
	0x33, // ##  ##
	0x33, // ##  ##
	0x37, // ### ##
	0x37, // ### ##
	0x3B, // ## ###
	0x3B, // ## ###
	0x33, // ##  ##
	0x33, // ##  ##

	// @363 'O' (7 pixels wide)
	0x1C, //   ###
	0x36, //  ## ##
	0x63, // ##   ##
	0x63, // ##   ##
	0x63, // ##   ##
	0x63, // ##   ##
	0x36, //  ## ##
	0x1C, //   ###

	// @371 'P' (6 pixels wide)
	0x1F, // #####
	0x33, // ##  ##
	0x33, // ##  ##
	0x33, // ##  ##
	0x1F, // #####
	0x03, // ##
	0x03, // ##
	0x03, // ##

	// @379 'Q' (7 pixels wide)
	0x1C, //   ###
	0x36, //  ## ##
	0x63, // ##   ##
	0x63, // ##   ##
	0x63, // ##   ##
	0x6B, // ## # ##
	0x36, //  ## ##
	0x3C, //   ####
	0x40, //       #

	// @388 'R' (7 pixels wide)
	0x1F, // #####
	0x33, // ##  ##
	0x33, // ##  ##
	0x33, // ##  ##
	0x1F, // #####
	0x1B, // ## ##
	0x33, // ##  ##
	0x63, // ##   ##

	// @396 'S' (6 pixels wide)
	0x1E, //  ####
	0x33, // ##  ##
	0x03, // ##
	0x0F, // ####
	0x3C, //   ####
	0x30, //     ##
	0x33, // ##  ##
	0x1E, //  ####

	// @404 'T' (6 pixels wide)
	0x3F, // ######
	0x0C, //   ##
	0x0C, //   ##
	0x0C, //   ##
	0x0C, //   ##
	0x0C, //   ##
	0x0C, //   ##
	0x0C, //   ##

	// @412 'U' (6 pixels wide)
	0x33, // ##  ##
	0x33, // ##  ##
	0x33, // ##  ##
	0x33, // ##  ##
	0x33, // ##  ##
	0x33, // ##  ##
	0x33, // ##  ##
	0x1E, //  ####

	// @420 'V' (7 pixels wide)
	0x63, // ##   ##
	0x63, // ##   ##
	0x36, //  ## ##
	0x36, //  ## ##
	0x36, //  ## ##
	0x36, //  ## ##
	0x1C, //   ###
	0x1C, //   ###

	// @428 'W' (11 pixels wide)
	0x23, 0x06, // ##   #   ##
	0x73, 0x06, // ##  ###  ##
	0x76, 0x03, //  ## ### ##
	0x56, 0x03, //  ## # # ##
	0x56, 0x03, //  ## # # ##
	0xDE, 0x03, //  #### ####
	0x8C, 0x01, //   ##   ##
	0x8C, 0x01, //   ##   ##

	// @444 'X' (6 pixels wide)
	0x33, // ##  ##
	0x33, // ##  ##
	0x1E, //  ####
	0x0C, //   ##
	0x0C, //   ##
	0x1E, //  ####
	0x33, // ##  ##
	0x33, // ##  ##

	// @452 'Y' (6 pixels wide)
	0x33, // ##  ##
	0x33, // ##  ##
	0x12, //  #  #
	0x1E, //  ####
	0x0C, //   ##
	0x0C, //   ##
	0x0C, //   ##
	0x0C, //   ##

	// @460 'Z' (6 pixels wide)
	0x3F, // ######
	0x30, //     ##
	0x18, //    ##
	0x0C, //   ##
	0x0C, //   ##
	0x06, //  ##
	0x03, // ##
	0x3F, // ######

	// @468 '[' (3 pixels wide)
	0x07, // ###
	0x03, // ##
	0x03, // ##
	0x03, // ##
	0x03, // ##
	0x03, // ##
	0x03, // ##
	0x03, // ##
	0x03, // ##
	0x07, // ###

	// @478 '\' (3 pixels wide)
	0x01, // #
	0x01, // #
	0x02, //  #
	0x02, //  #
	0x02, //  #
	0x02, //  #
	0x04, //   #
	0x04, //   #

	// @486 ']' (3 pixels wide)
	0x07, // ###
	0x06, //  ##
	0x06, //  ##
	0x06, //  ##
	0x06, //  ##
	0x06, //  ##
	0x06, //  ##
	0x06, //  ##
	0x06, //  ##
	0x07, // ###

	// @496 '^' (5 pixels wide)
	0x04, //   #
	0x0E, //  ###
	0x0A, //  # #
	0x1B, // ## ##

	// @500 '_' (6 pixels wide)
	0x3F, // ######

	// @501 '`' (3 pixels wide)
	0x03, // ##
	0x06, //  ##

	// @503 'a' (5 pixels wide)
	0x0E, //  ###
	0x19, // #  ##
	0x1E, //  ####
	0x1B, // ## ##
	0x1B, // ## ##
	0x1E, //  ####

	// @509 'b' (6 pixels wide)
	0x03, // ##
	0x03, // ##
	0x1F, // #####
	0x33, // ##  ##
	0x33, // ##  ##
	0x33, // ##  ##
	0x33, // ##  ##
	0x1F, // #####

	// @517 'c' (5 pixels wide)
	0x0E, //  ###
	0x1B, // ## ##
	0x03, // ##
	0x03, // ##
	0x1B, // ## ##
	0x0E, //  ###

	// @523 'd' (6 pixels wide)
	0x30, //     ##
	0x30, //     ##
	0x3E, //  #####
	0x33, // ##  ##
	0x33, // ##  ##
	0x33, // ##  ##
	0x33, // ##  ##
	0x3E, //  #####

	// @531 'e' (6 pixels wide)
	0x1E, //  ####
	0x33, // ##  ##
	0x3F, // ######
	0x03, // ##
	0x33, // ##  ##
	0x1E, //  ####

	// @537 'f' (5 pixels wide)
	0x1C, //   ###
	0x06, //  ##
	0x0F, // ####
	0x06, //  ##
	0x06, //  ##
	0x06, //  ##
	0x06, //  ##
	0x06, //  ##

	// @545 'g' (6 pixels wide)
	0x3E, //  #####
	0x33, // ##  ##
	0x33, // ##  ##
	0x33, // ##  ##
	0x33, // ##  ##
	0x3E, //  #####
	0x31, // #   ##
	0x1E, //  ####

	// @553 'h' (6 pixels wide)
	0x03, // ##
	0x03, // ##
	0x1F, // #####
	0x33, // ##  ##
	0x33, // ##  ##
	0x33, // ##  ##
	0x33, // ##  ##
	0x33, // ##  ##

	// @561 'i' (2 pixels wide)
	0x03, // ##
	0x00, //
	0x03, // ##
	0x03, // ##
	0x03, // ##
	0x03, // ##
	0x03, // ##
	0x03, // ##

	// @569 'j' (3 pixels wide)
	0x06, //  ##
	0x00, //
	0x06, //  ##
	0x06, //  ##
	0x06, //  ##
	0x06, //  ##
	0x06, //  ##
	0x06, //  ##
	0x06, //  ##
	0x03, // ##

	// @579 'k' (6 pixels wide)
	0x03, // ##
	0x03, // ##
	0x33, // ##  ##
	0x1B, // ## ##
	0x0F, // ####
	0x1F, // #####
	0x1B, // ## ##
	0x33, // ##  ##

	// @587 'l' (2 pixels wide)
	0x03, // ##
	0x03, // ##
	0x03, // ##
	0x03, // ##
	0x03, // ##
	0x03, // ##
	0x03, // ##
	0x03, // ##

	// @595 'm' (10 pixels wide)
	0xFF, 0x01, // #########
	0x33, 0x03, // ##  ##  ##
	0x33, 0x03, // ##  ##  ##
	0x33, 0x03, // ##  ##  ##
	0x33, 0x03, // ##  ##  ##
	0x33, 0x03, // ##  ##  ##

	// @607 'n' (6 pixels wide)
	0x1F, // #####
	0x33, // ##  ##
	0x33, // ##  ##
	0x33, // ##  ##
	0x33, // ##  ##
	0x33, // ##  ##

	// @613 'o' (6 pixels wide)
	0x1E, //  ####
	0x33, // ##  ##
	0x33, // ##  ##
	0x33, // ##  ##
	0x33, // ##  ##
	0x1E, //  ####

	// @619 'p' (6 pixels wide)
	0x1F, // #####
	0x33, // ##  ##
	0x33, // ##  ##
	0x33, // ##  ##
	0x33, // ##  ##
	0x1F, // #####
	0x03, // ##
	0x03, // ##

	// @627 'q' (6 pixels wide)
	0x3E, //  #####
	0x33, // ##  ##
	0x33, // ##  ##
	0x33, // ##  ##
	0x33, // ##  ##
	0x3E, //  #####
	0x30, //     ##
	0x30, //     ##

	// @635 'r' (4 pixels wide)
	0x0F, // ####
	0x03, // ##
	0x03, // ##
	0x03, // ##
	0x03, // ##
	0x03, // ##

	// @641 's' (6 pixels wide)
	0x1E, //  ####
	0x33, // ##  ##
	0x0F, // ####
	0x3C, //   ####
	0x33, // ##  ##
	0x1E, //  ####

	// @647 't' (4 pixels wide)
	0x04, //   #
	0x06, //  ##
	0x0F, // ####
	0x06, //  ##
	0x06, //  ##
	0x06, //  ##
	0x06, //  ##
	0x0C, //   ##

	// @655 'u' (6 pixels wide)
	0x33, // ##  ##
	0x33, // ##  ##
	0x33, // ##  ##
	0x33, // ##  ##
	0x33, // ##  ##
	0x3E, //  #####

	// @661 'v' (5 pixels wide)
	0x1B, // ## ##
	0x1B, // ## ##
	0x1B, // ## ##
	0x1B, // ## ##
	0x0E, //  ###
	0x0E, //  ###

	// @667 'w' (9 pixels wide)
	0x93, 0x01, // ##  #  ##
	0xBB, 0x01, // ## ### ##
	0xBB, 0x01, // ## ### ##
	0xEE, 0x00, //  ### ###
	0xEE, 0x00, //  ### ###
	0xC6, 0x00, //  ##   ##

	// @679 'x' (5 pixels wide)
	0x1B, // ## ##
	0x1B, // ## ##
	0x0E, //  ###
	0x0E, //  ###
	0x1B, // ## ##
	0x1B, // ## ##

	// @685 'y' (7 pixels wide)
	0x63, // ##   ##
	0x36, //  ## ##
	0x36, //  ## ##
	0x36, //  ## ##
	0x1C, //   ###
	0x1C, //   ###
	0x0C, //   ##
	0x07, // ###

	// @693 'z' (5 pixels wide)
	0x1F, // #####
	0x18, //    ##
	0x0C, //   ##
	0x06, //  ##
	0x03, // ##
	0x1F, // #####

	// @699 '{' (4 pixels wide)
	0x0C, //   ##
	0x06, //  ##
	0x06, //  ##
	0x06, //  ##
	0x06, //  ##
	0x03, // ##
	0x06, //  ##
	0x06, //  ##
	0x06, //  ##
	0x0C, //   ##

	// @709 '|' (1 pixels wide)
	0x01, // #
	0x01, // #
	0x01, // #
	0x01, // #
	0x01, // #
	0x01, // #
	0x01, // #
	0x01, // #
	0x01, // #
	0x01, // #

	// @719 '}' (4 pixels wide)
	0x03, // ##
	0x06, //  ##
	0x06, //  ##
	0x06, //  ##
	0x06, //  ##
	0x0C, //   ##
	0x06, //  ##
	0x06, //  ##
	0x06, //  ##
	0x03, // ##

	// @729 '~' (5 pixels wide)
	0x16, //  ## #
	0x09, // #  #
};

// Character descriptors for Arial 8pt
// { [Char width in bits], [Char height in bits], [Offset into arial_8ptCharBitmaps in bytes] }
const unsigned int arial_8ptDescriptors[96][3] =
{
	{2, 14, 0}, 		//
	{2, 8, 14}, 		// !
	{5, 3, 22}, 		// "
	{6, 8, 25}, 		// #
	{5, 10, 33}, 		// $
	{8, 8, 43}, 		// %
	{7, 8, 51}, 		// &
	{2, 3, 59}, 		// '
	{3, 10, 62}, 		// (
	{3, 10, 72}, 		// )
	{3, 4, 82}, 		// *
	{5, 5, 86}, 		// +
	{2, 4, 91}, 		// ,
	{3, 1, 95}, 		// -
	{2, 2, 96}, 		// .
	{3, 8, 98}, 		// /
	{5, 8, 106}, 		// 0
	{4, 8, 114}, 		// 1
	{5, 8, 122}, 		// 2
	{5, 8, 130}, 		// 3
	{6, 8, 138}, 		// 4
	{5, 8, 146}, 		// 5
	{5, 8, 154}, 		// 6
	{5, 8, 162}, 		// 7
	{5, 8, 170}, 		// 8
	{5, 8, 178}, 		// 9
	{2, 6, 186}, 		// :
	{2, 8, 192}, 		// ;
	{5, 6, 200}, 		// <
	{5, 3, 206}, 		// =
	{5, 6, 209}, 		// >
	{5, 8, 215}, 		// ?
	{10, 10, 223}, 		// @
	{7, 8, 243}, 		// A
	{6, 8, 251}, 		// B
	{7, 8, 259}, 		// C
	{6, 8, 267}, 		// D
	{5, 8, 275}, 		// E
	{5, 8, 283}, 		// F
	{7, 8, 291}, 		// G
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
};


//
//  Font data for Courier New 16pt
//

// Character bitmaps for Courier New 16pt
const unsigned char courierNew_16ptBitmaps[] =
{
	// @0 ' ' (15 pixels wide)
	0x00, 0x00, //
	0x00, 0x00, //
	0x00, 0x00, //
	0x00, 0x00, //
	0x00, 0x00, //
	0x00, 0x00, //
	0x00, 0x00, //
	0x00, 0x00, //
	0x00, 0x00, //
	0x00, 0x00, //
	0x00, 0x00, //
	0x00, 0x00, //
	0x00, 0x00, //
	0x00, 0x00, //
	0x00, 0x00, //
	0x00, 0x00, //
	0x00, 0x00, //
	0x00, 0x00, //
	0x00, 0x00, //
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
	0x00, 0x00, //
	0x70, 0x0C, //     ###   ##
	0xF8, 0x0E, //    ##### ###
	0xDC, 0x07, //   ### #####
	0x8C, 0x03, //   ##   ###
	0x00, 0x00, //
	0x00, 0x00, //
	0x00, 0x00, //
	0x00, 0x00, //
	0x00, 0x00, //
	0x00, 0x00, //
	0x00, 0x00, //
	0x00, 0x00, //
	0x00, 0x00, //
	0x00, 0x00, //
};

// Character descriptors for Courier New 16pt
// { [Char width in bits], [Char height in bits], [Offset into courierNew_16ptCharBitmaps in bytes] }
const unsigned int courierNew_16ptDescriptors[96][3] =
{
	{15, 15, 0}, 		//
	{15, 15, 42}, 		// !
	{15, 15, 84}, 		// "
	{15, 15, 126}, 		// #
	{15, 15, 168}, 		// $
	{15, 15, 210}, 		// %
	{15, 15, 252}, 		// &
	{15, 15, 294}, 		// '
	{15, 15, 336}, 		// (
	{15, 15, 378}, 		// )
	{15, 15, 420}, 		// *
	{15, 15, 462}, 		// +
	{15, 15, 504}, 		// ,
	{15, 15, 546}, 		// -
	{15, 15, 588}, 		// .
	{15, 15, 630}, 		// 
	{15, 15, 672}, 		// 0
	{15, 15, 714}, 		// 1
	{15, 15, 756}, 		// 2
	{15, 15, 798}, 		// 3
	{15, 15, 840}, 		// 4
	{15, 15, 882}, 		// 5
	{15, 15, 924}, 		// 6
	{15, 15, 966}, 		// 7
	{15, 15, 1008}, 		// 8
	{15, 15, 1050}, 		// 9
	{15, 15, 1092}, 		// :
	{15, 15, 1134}, 		// ;
	{15, 15, 1176}, 		// <
	{15, 15, 1218}, 		// =
	{15, 15, 1260}, 		// >
	{15, 15, 1302}, 		// ?
	{15, 15, 1344}, 		// @
	{15, 15, 1386}, 		// A
	{15, 15, 1428}, 		// B
	{15, 15, 1470}, 		// C
	{15, 15, 1512}, 		// D
	{15, 15, 1554}, 		// E
	{15, 15, 1596}, 		// F
	{15, 15, 1638}, 		// G
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
};

//
//  Font data for Freestyle Script 22pt
//
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
