reportingsjr/mppt/(commit log)

2019-10-18 Very rough start of MPPT design.
    [mmpt_power_controller.kicad_pcb, mmpt_power_controller.sch]
2019-10-20 Add KiCad specific .gitignore.
2019-10-20 Fix typo in KiCad filenames.
    [mppt_power_controller.kicad_pcb, mppt_power_controller.sch]
2019-10-20 Add LT3080 as 3.3V regulator, remove input/output solar and battery protection, add ARM JTAG connector, all symbols now have footprints.
    [mppt_power_controller.sch]
2019-10-20 Wire up most of microcontroller, add some placeholder outputs, fix a small mistake on the TPS61090 boost controller.
    [mppt_power_controller.sch]
2019-10-24 Add PX3519 synchronous FET driver, a handful of testpoints, and clear ERC.
    [mppt_power_controller.sch]
2019-10-24 Move yellow LED text that will not stop moving.
    [mppt_power_controller.sch]
2019-10-24 Fix the footprints for a few components.
    [mppt_power_controller.sch]
2019-10-24 Move footprints to general locations on the PCB and start with a 100mmx50mm board outline.
    [mppt_power_controller.kicad_pcb]
2019-10-24 Routed a good portion of the buck converter and the first voltage/current monitor.
    [mppt_power_controller.kicad_pcb]
2019-10-24 Add PDF of schematic
2019-10-24 Add four M3 mounting holes so I dont hate myself later.
    [mppt_power_controller.kicad_pcb, mppt_power_controller.sch]
2019-10-24 Put mounting holes 5mm in from board edge.
    [mppt_power_controller.kicad_pcb]
2019-10-24 Add some input capacitance for the solar panel
    [mppt_power_controller.kicad_pcb, mppt_power_controller.sch]
2019-10-25 Route a good amount of the microcontroller as well as the 5V power supply.
    [mppt_power_controller.kicad_pcb, mppt_power_controller.sch]
2019-10-30 Change INA233 from "rescue" library to real library. Small mistake!
    [mppt_power_controller.sch]
2019-11-01 Move around 5V SMPS
    [mppt_power_controller.kicad_pcb, mppt_power_controller.sch]
2019-11-01 Add a test point for VBat. Route rest of power, I2C, test points, and everything else! Lots of cleanup needed from here to make the board look nice, but all of the nets have been routed.
    [mppt_power_controller.kicad_pcb, mppt_power_controller.sch]
2019-11-01 Remove test point reference designators. Also labelled some of the different circuits on the PCB.
    [mppt_power_controller.kicad_pcb]
2019-11-01 Flip solar panel connector around so pin 1 is power and pin 2 is ground like every other board with JST connectors.
    [mppt_power_controller.kicad_pcb, mppt_power_controller.sch]
2019-11-01 Version 1 gerbers added.
2019-11-08 Switch I2C pins from SERCOM0 which does not support I2C to SERCOM2. Schematic only, board has not been fixed.
    [mppt_power_controller.sch]
2019-11-20 Update design notes a bit and add the hex addresses of the power monitors to the schematic.
    [mppt_power_controller.sch]
2019-11-20 Add amazing interactive bom for assembly
2019-11-20 This commit adds a large amount of code from atmel start. Much of it is very boiler plate and inefficient, but it works!
    This boots the micro with an internal 8MHz oscillator as the core clock.
    A 50kHz PWM signal is output as well as an enable signal for the FET
    controller.
    This also reads voltages from both of the power monitoring ICs.
    Very messy at this point, but this is a good base.
    [atmel_start_pins.h, driver_examples.c, driver_init.c, driver_init.h]
2019-11-20 Updated gitignore to ignore files from building power electronics firmware.
2019-11-21 Fix a couple small mistakes
    [ina233.c, main.c]
2019-11-21 Modify get_current function to use I2C transfer in a different manner. The INA233 may not be responding with the current because the calibration register isn't being written. I think this is because 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
    See page 19 (Writing to and Reading From the INA233) to see what it expects
    for writing to a register.
2019-11-21 Fix bug where get_current was returning zero even though it received the correct values over I2C.
    Replace the test I2C register write code with two functions to handle doing that more cleanly.
    [ina233.c, ina233.h]
2019-11-21 Added a function to update the INA233 ADC config as well as a bunch of defines for this function.
2019-12-03 Add an IV curve image of the solar cell and an image of the schematic.
2020-04-10 Add some new datasheets, modify code to only flash LEDs as a starting point.
    [mppt_power_controller.kicad_pcb, mppt_power_controller.sch]
2020-04-17 Add SSD1306 OLED display driver. Set up main.c to display input and output voltage/current on the display.
